ionutms/freecad-jumper-wire-pen/README.md

# Jumper wire pen

A 3D-printable pen for laying jumper wire on a circuit board, to repair broken traces. Very thin wire
(0.02 to 0.1 mm) comes off a small bought spool inside the pen, runs through the body and leaves through a
bought needle tube at the tip.

All the printed parts come from **one FreeCAD macro**. Every size is a field in a small window that stays
open next to the 3D view, and the model rebuilds a moment after you change a number.

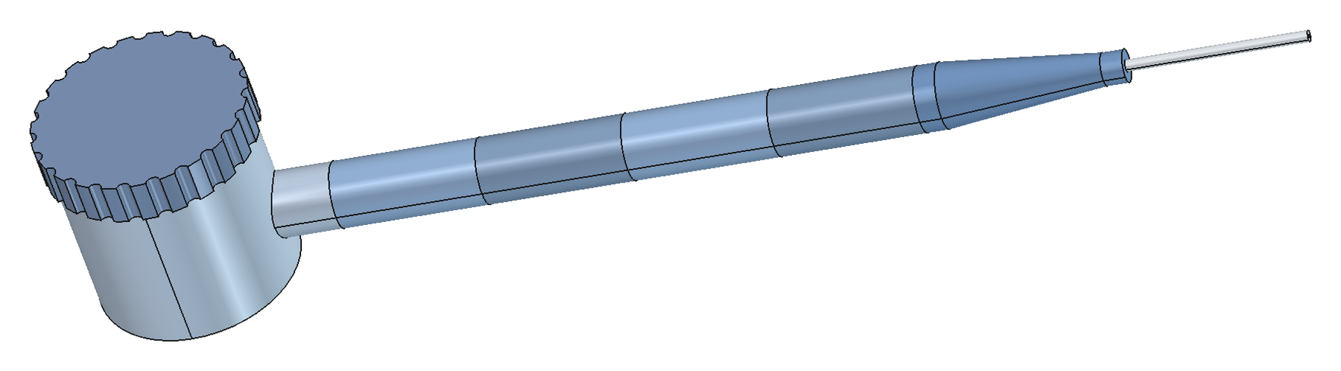
[picture p1: images/assembled.png]
The assembled pen


> **Status:** the design has not been test-printed yet. The macro checks in FreeCAD that the parts do not
> overlap (the **Check fit** button reports 0 overlap at the default sizes), but the parts have not yet been printed and
> screwed together. It was written and tried in FreeCAD 1.1 on Windows; other versions are untested.

## The parts

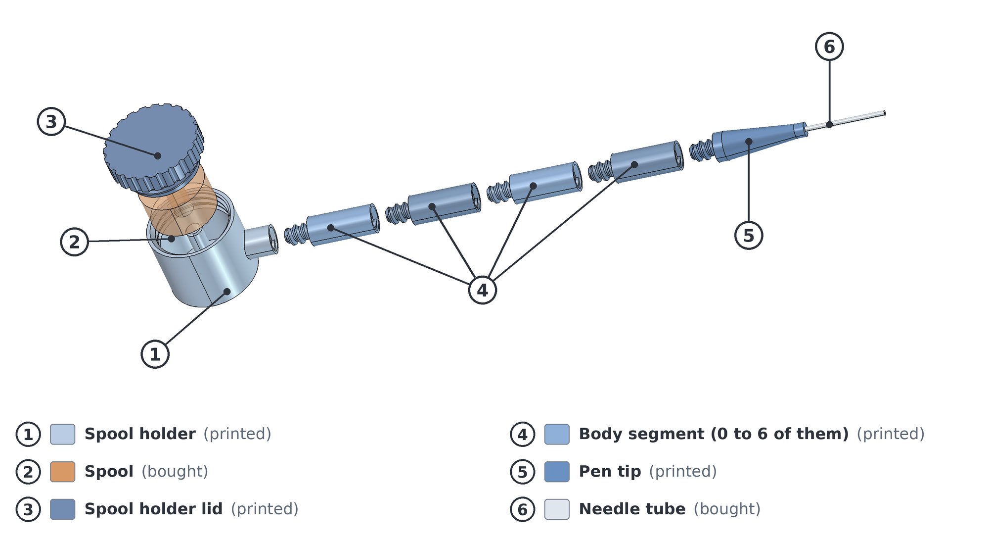
[picture p2: images/exploded_view.png]
Exploded view of the pen


| # | Part | Printed or bought | What it does |
| --- | --- | --- | --- |
| 1 | Spool holder | printed | Round drum at the rear of the pen. The spool lies on its side inside, on a pin, centred on the pen axis. One threaded socket at the front takes the first body segment (or the tip). |
| 2 | Spool | bought | Not printed. The defaults are set for a small spool: 21 mm across, 12 mm wide, centre hole 6 mm. |
| 3 | Spool holder lid | printed | The big round knob on top. It screws on and off by hand. Its hub holds the top end of the pin. Mostly hollow, to save plastic. |
| 4 | Body segment | printed | All segments are identical: a threaded stub at one end, a threaded socket at the other. Use 0 to 6 of them to set the length of the pen. |
| 5 | Pen tip | printed | The tapered nose. It holds the needle tube. |
| 6 | Needle tube | bought | Not printed. The default is 1.6 mm outside diameter, 0.6 mm inside, 25 mm sticking out of the tip. |

The wire leaves the rim of the spool into a funnel, runs along the pen through a 1.5 mm hole in every part and comes out of the needle tube.
Put together with the default sizes and 4 body segments, the pen is 143 mm long.

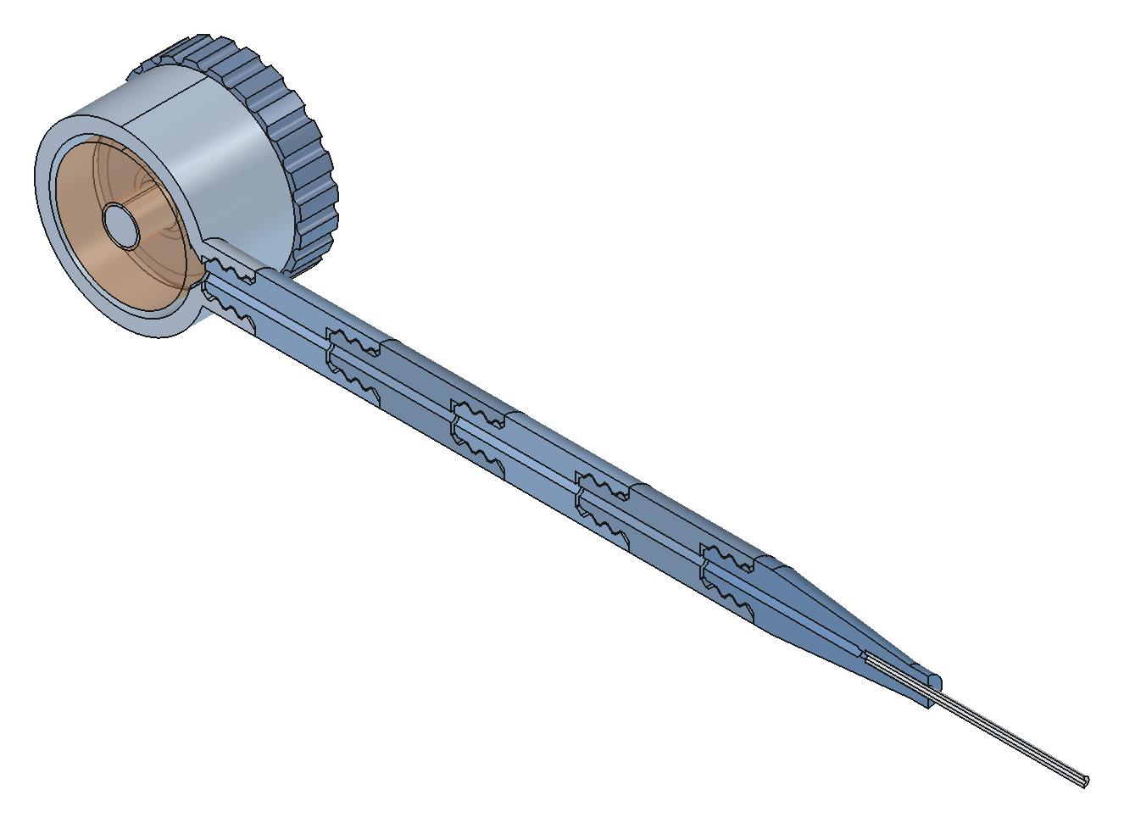
[picture p3: images/section_iso.png]
Cut through the middle of the pen


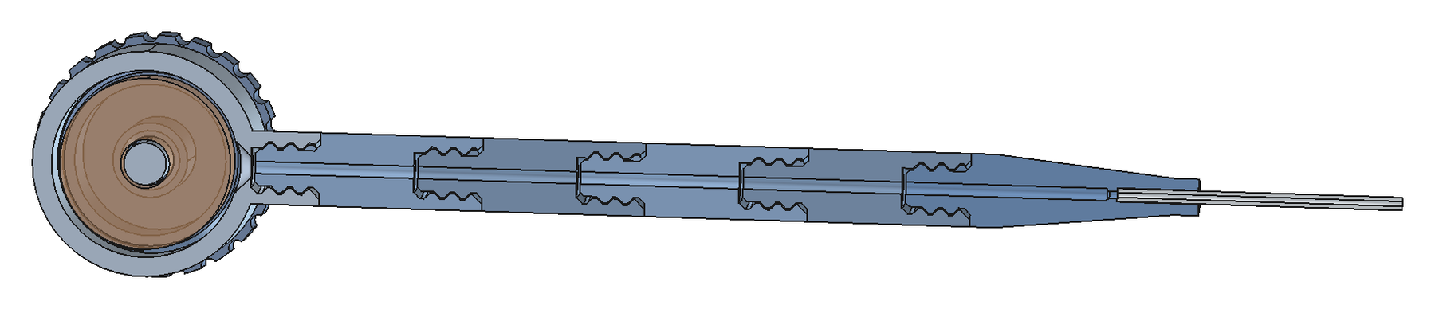
[picture p4: images/section_side.png]
Side view of the cut, showing the threads


## Install and run

1. Install [FreeCAD](https://www.freecad.org/).
2. Copy `jumper_wire_pen_assembly.FCMacro` into your FreeCAD macro folder (the folder shown in **Macro > Macros...**).
3. Choose **Macro > Macros...**, pick `jumper_wire_pen_assembly`, and press **Execute**.

A window opens and **stays open** while you work, so you can change sizes and watch the 3D view. The macro creates a
document called `JumperWirePen_Assembly` for you. Your last values are remembered. Running the macro again replaces the window.
Close the window when you are done.

## The window

Every setting has a tab. The text under the tabs shows the resulting pen length, the thread numbers, the fit,
and any warnings. If a value makes a part impossible (for example a thread too short for its step), the model keeps its last good shape and the text says why.

Buttons: **Check fit** puts the parts together as they really mate and reports the overlap of every joint (it can take up to a
minute). **Reset sizes** puts all sizes and view options back to their defaults. **Fit view** frames the model. **Close** closes the window.

### Tip shape

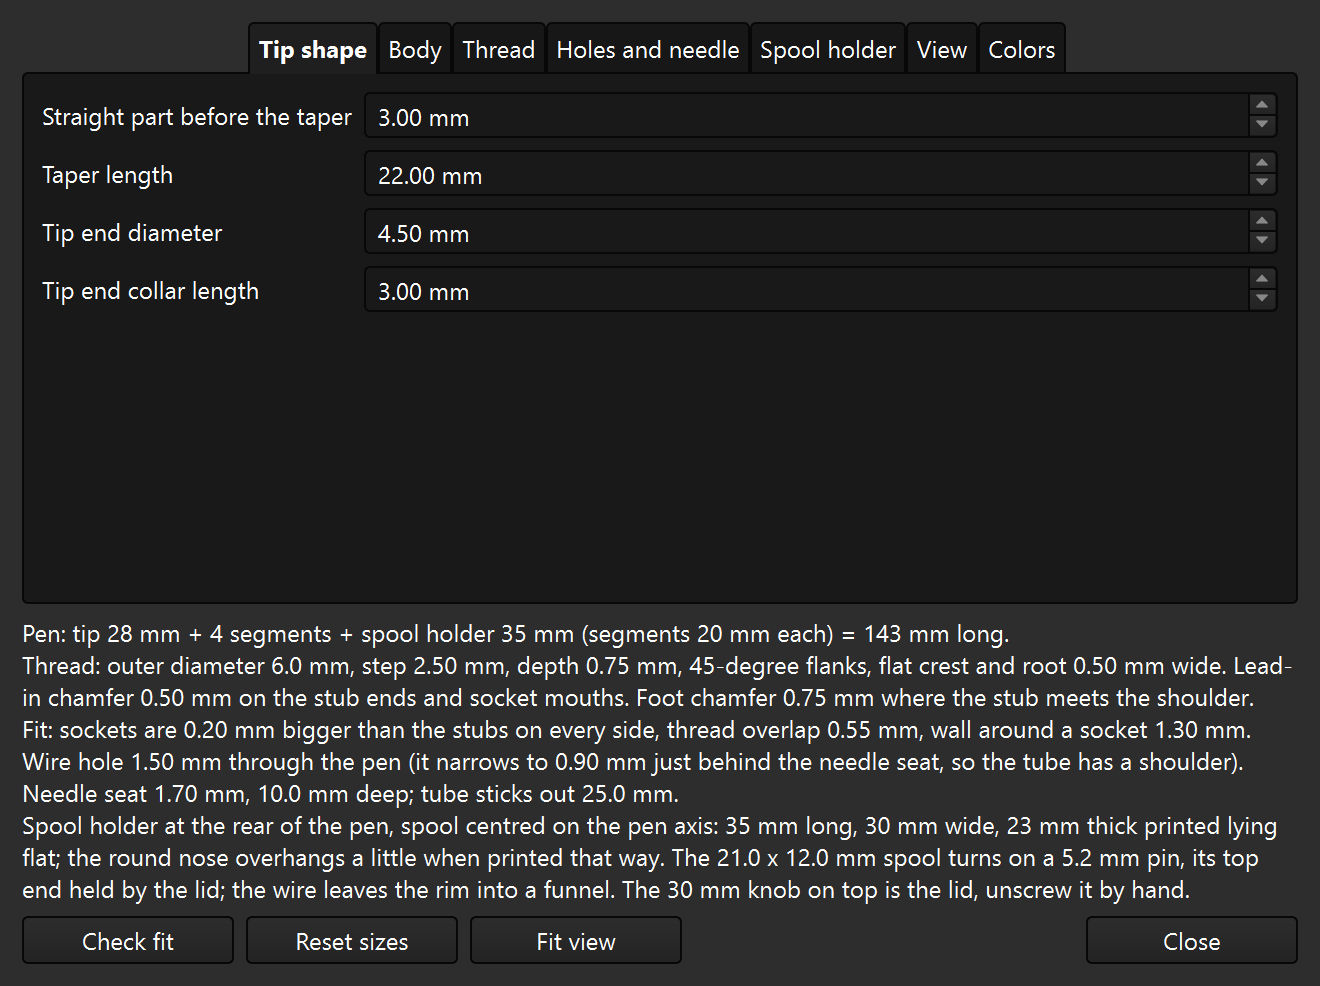
[picture p5: images/tab_1_tip_shape.png]
Tip shape tab


| Setting | Default | Range |
| --- | --- | --- |
| Straight part before the taper | 3 mm | 0.5 to 20 mm |
| Taper length | 22 mm | 5 to 100 mm |
| Tip end diameter | 4.5 mm | 3 to 15 mm |
| Tip end collar length | 3 mm | 1 to 15 mm |

### Body

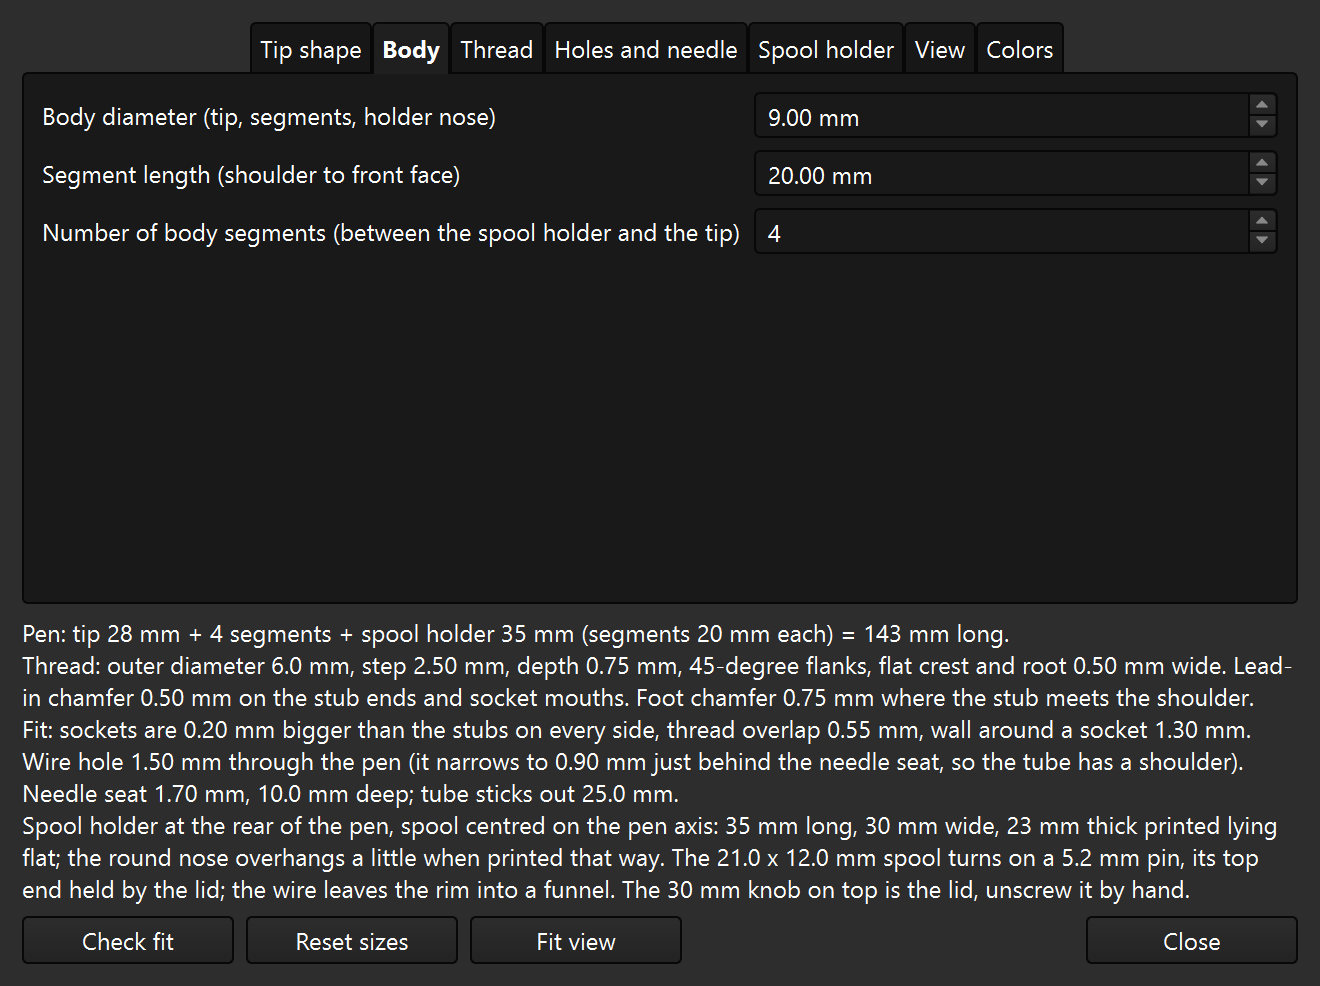
[picture p6: images/tab_2_body.png]
Body tab


| Setting | Default | Range |
| --- | --- | --- |
| Body diameter (tip, segments, holder nose) | 9 mm | 6 to 30 mm |
| Segment length (shoulder to front face) | 20 mm | 6 to 60 mm |
| Number of body segments (between the spool holder and the tip) | 4 | 0 to 6 |

The body diameter is shared by the tip, the segments and the nose of the spool holder.

### Thread

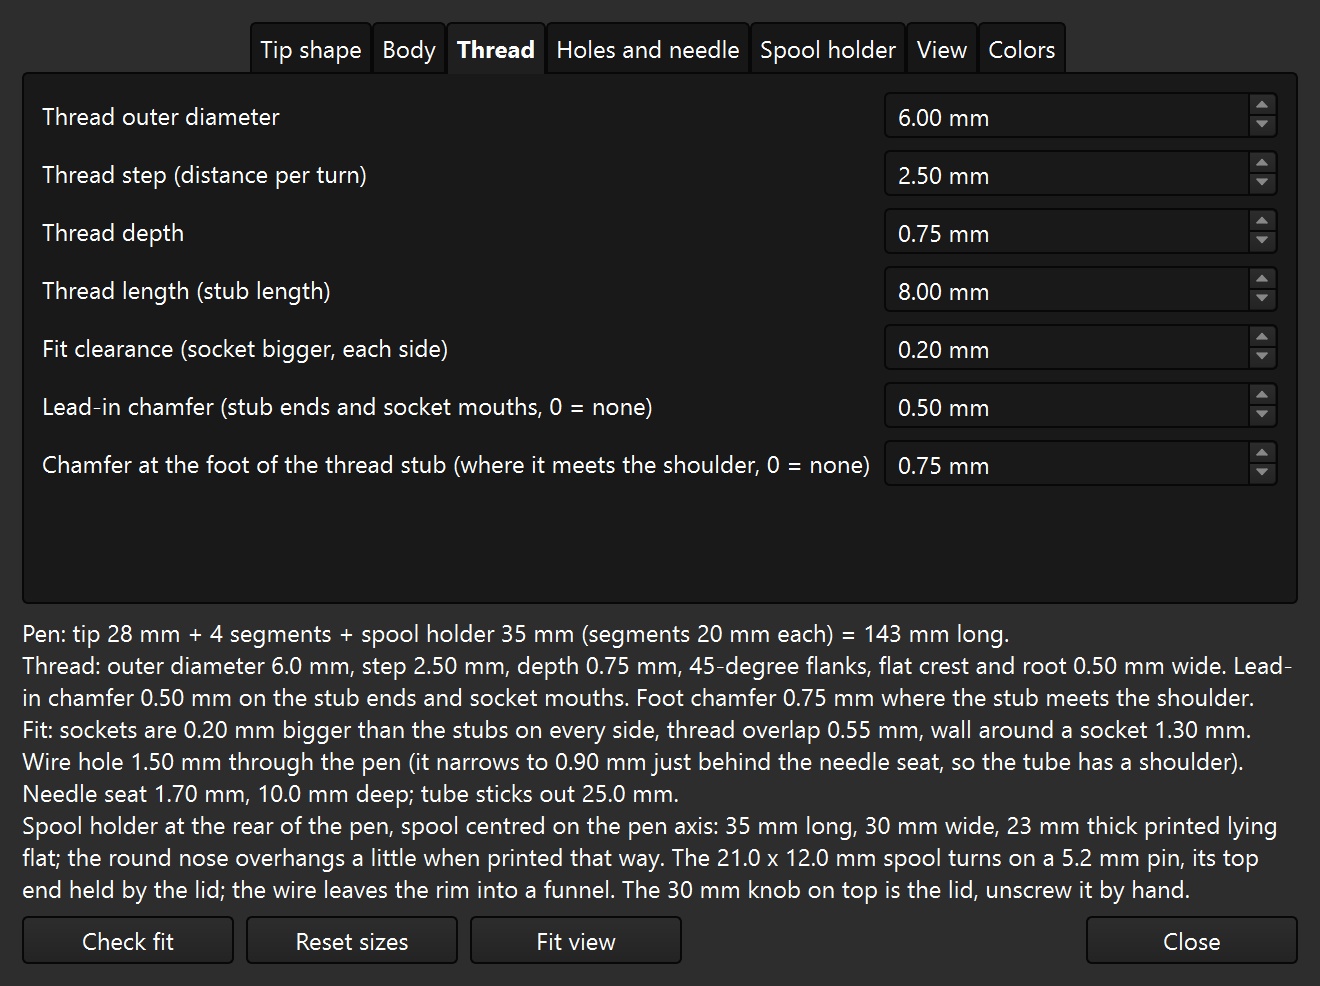
[picture p7: images/tab_3_thread.png]
Thread tab


| Setting | Default | Range |
| --- | --- | --- |
| Thread outer diameter | 6 mm | 3 to 28 mm |
| Thread step (distance per turn) | 2.5 mm | 1 to 6 mm |
| Thread depth | 0.75 mm | 0.3 to 2.5 mm |
| Thread length (stub length) | 8 mm | 4 to 24 mm |
| Fit clearance (socket bigger, each side) | 0.2 mm | 0 to 0.6 mm |
| Lead-in chamfer (stub ends and socket mouths, 0 = none) | 0.5 mm | 0 to 1.5 mm |
| Chamfer at the foot of the thread stub (where it meets the shoulder, 0 = none) | 0.75 mm | 0 to 1.5 mm |

The thread is shared by every part, so the parts always fit each other. It is made for FDM printing: a coarse step,
45-degree flanks (no flat overhangs), and flat crests and roots that are wider than one nozzle line (0.50 mm at the defaults).
The sockets are bigger than the stubs by the fit clearance on every side. If the threads bind or wobble on your printer, change that clearance.
If you change any thread setting, reprint all the parts, not just one.

Two small chamfers make the printed threads easier to use. The *lead-in chamfer* (0.5 mm) bevels the end of every
thread stub and opens every socket mouth with a matching 45-degree countersink. The parts start easily, and the squashed first layer
of a stub (it prints standing on the bed) no longer catches. The *foot chamfer* (0.75 mm) is a 45-degree slope where
the stub meets the shoulder, which makes the stub stronger. It sits inside the countersink of the socket, so the flat shoulder ring
still seats against the front face of the next part. Set either to 0 for a sharp edge. The foot chamfer is limited automatically
to the room the socket leaves for it.

### Holes and needle

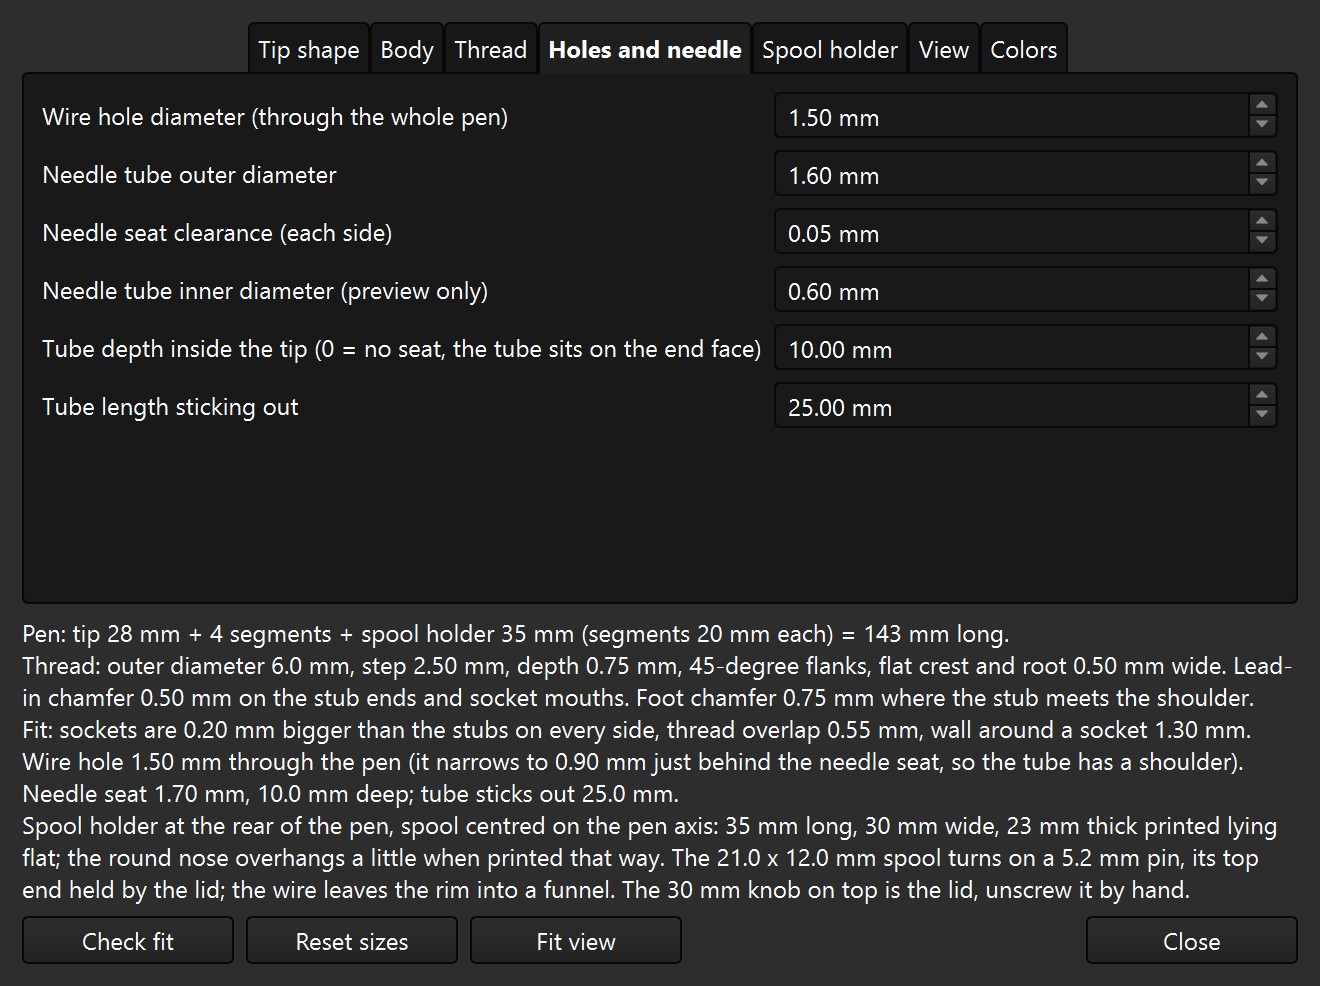
[picture p8: images/tab_4_holes_and_needle.png]
Holes and needle tab


| Setting | Default | Range |
| --- | --- | --- |
| Wire hole diameter (through the whole pen) | 1.5 mm | 0.3 to 6 mm |
| Needle tube outer diameter | 1.6 mm | 0.6 to 6 mm |
| Needle seat clearance (each side) | 0.05 mm | 0 to 0.5 mm |
| Needle tube inner diameter (preview only) | 0.6 mm | 0.2 to 5 mm |
| Tube depth inside the tip (0 = no seat, the tube sits on the end face) | 10 mm | 0 to 40 mm |
| Tube length sticking out | 25 mm | 5 to 60 mm |

Set the tube depth to 0 for a tip without a seat: the tube then sits on the end face of the tip, and you glue it there.

If the wire hole is almost as wide as the needle seat (as it is at the defaults, with a 1.5 mm hole and a
1.6 mm needle), the tube would have almost no shoulder to stop against. In that case the wire hole narrows with a
45-degree cone to a short neck just behind the seat, so the needle always has a shoulder. The text under the tabs reports the neck size.

### Spool holder

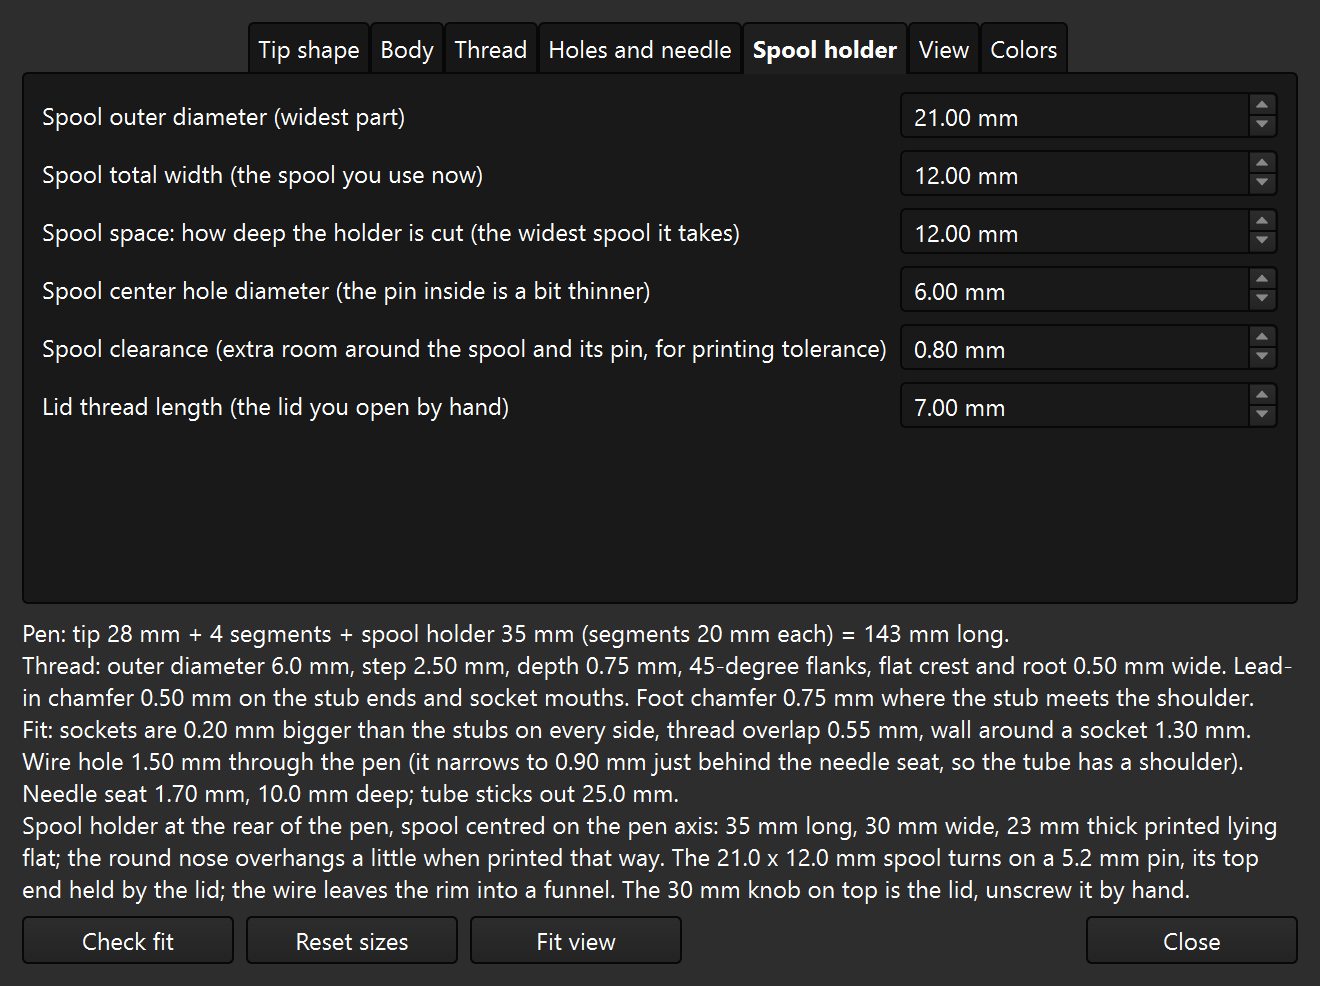
[picture p9: images/tab_5_spool_holder.png]
Spool holder tab


| Setting | Default | Range |
| --- | --- | --- |
| Spool outer diameter (widest part) | 21 mm | 8 to 60 mm |
| Spool total width (the spool you use now) | 12 mm | 2 to 30 mm |
| Spool space: how deep the holder is cut (the widest spool it takes) | 12 mm | 2 to 40 mm |
| Spool center hole diameter (the pin inside is a bit thinner) | 6 mm | 1 to 15 mm |
| Spool clearance (extra room around the spool and its pin, for printing tolerance) | 0.8 mm | 0 to 2 mm |
| Lid thread length (the lid you open by hand) | 7 mm | 3 to 16 mm |

*Spool space* sets how deep the holder is cut, so it decides the widest spool the holder takes. *Spool total width* is the spool you
use now. If your spool is narrower than the space, the text under the tabs tells you how many millimetres of washers or spacers to put
under it to keep it centred on the pen axis.

*Spool clearance* (0.8 mm by default) is extra room for printing tolerance, so that the spool still fits a printed holder. It leaves
1 mm of free space around the rim of the spool, 0.6 mm of play above and below it, and makes the pin 0.8 mm thinner
than the centre hole of the spool. Raise it if your spool is tight, lower it if the spool wobbles too much.

The defaults are set for a small spool (21 mm across, 12 mm wide, centre hole 6 mm). At these sizes the spool holder is the biggest part of the pen: 35 mm long, 28 mm wide and 23 mm thick, and 30 mm across the lid knob.

The lid has one setting of its own, the lid thread length. The lid thread is sized from the spool diameter, and its step, depth and
clearance are the shared thread settings. The holder length depends on the thread length of the body, because the first body segment
screws into the holder.

### View

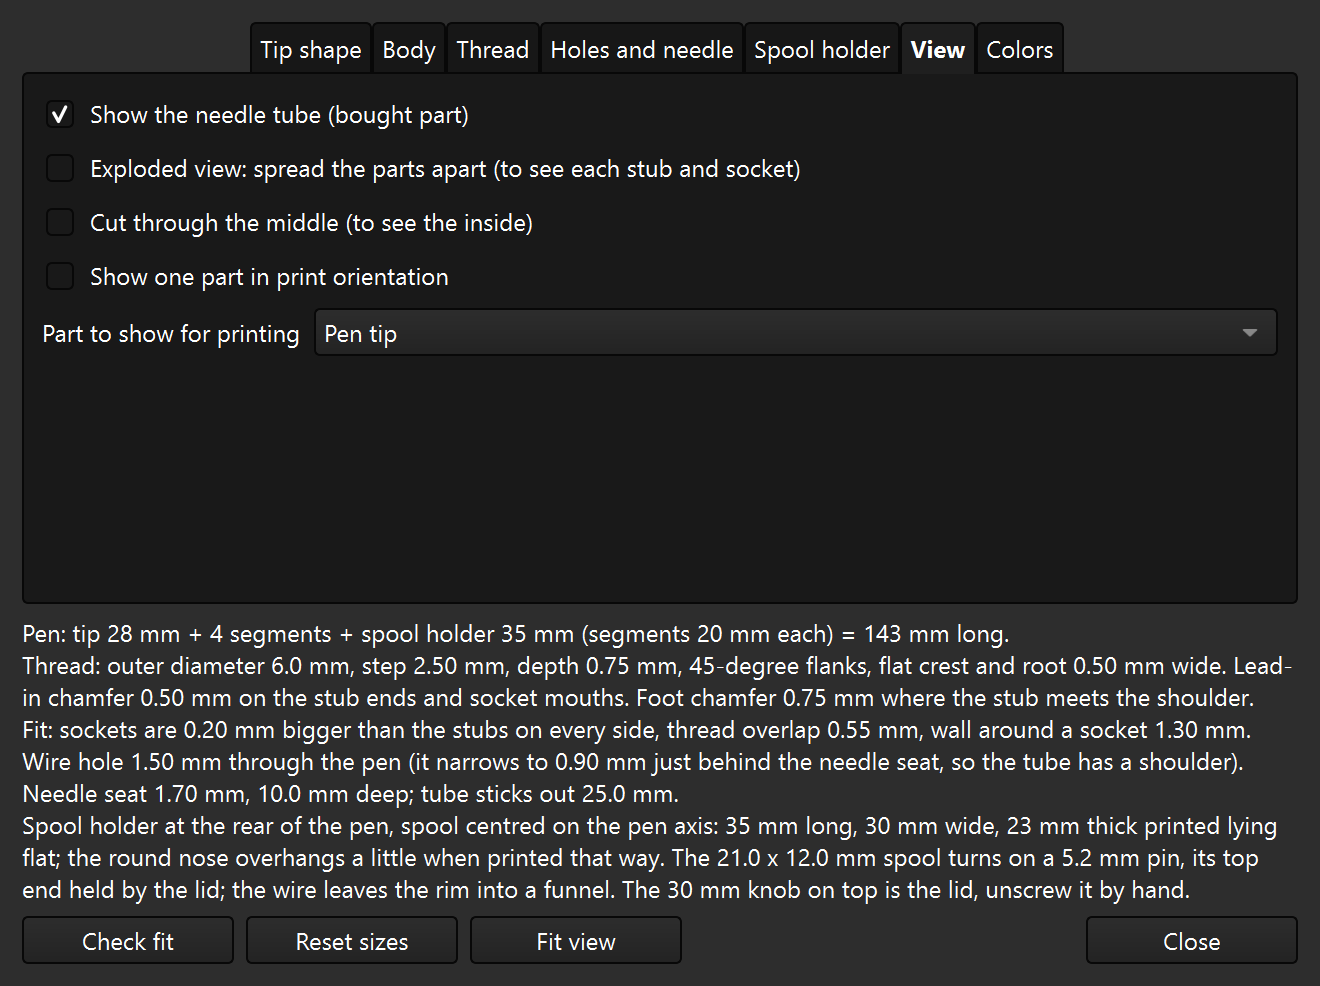
[picture p10: images/tab_6_view.png]
View tab


* **Show the needle tube**: shows or hides the bought needle tube.
* **Exploded view**: spreads the parts apart so you can see every stub and socket. The spool and the lid lift clear of the holder. The exploded picture near the top is this view with numbers added.
* **Cut through the middle**: cuts the model in half to show the inside.
* **Show one part in print orientation**: shows only the part chosen in *Part to show for printing*, turned the way it is printed.

### Colors

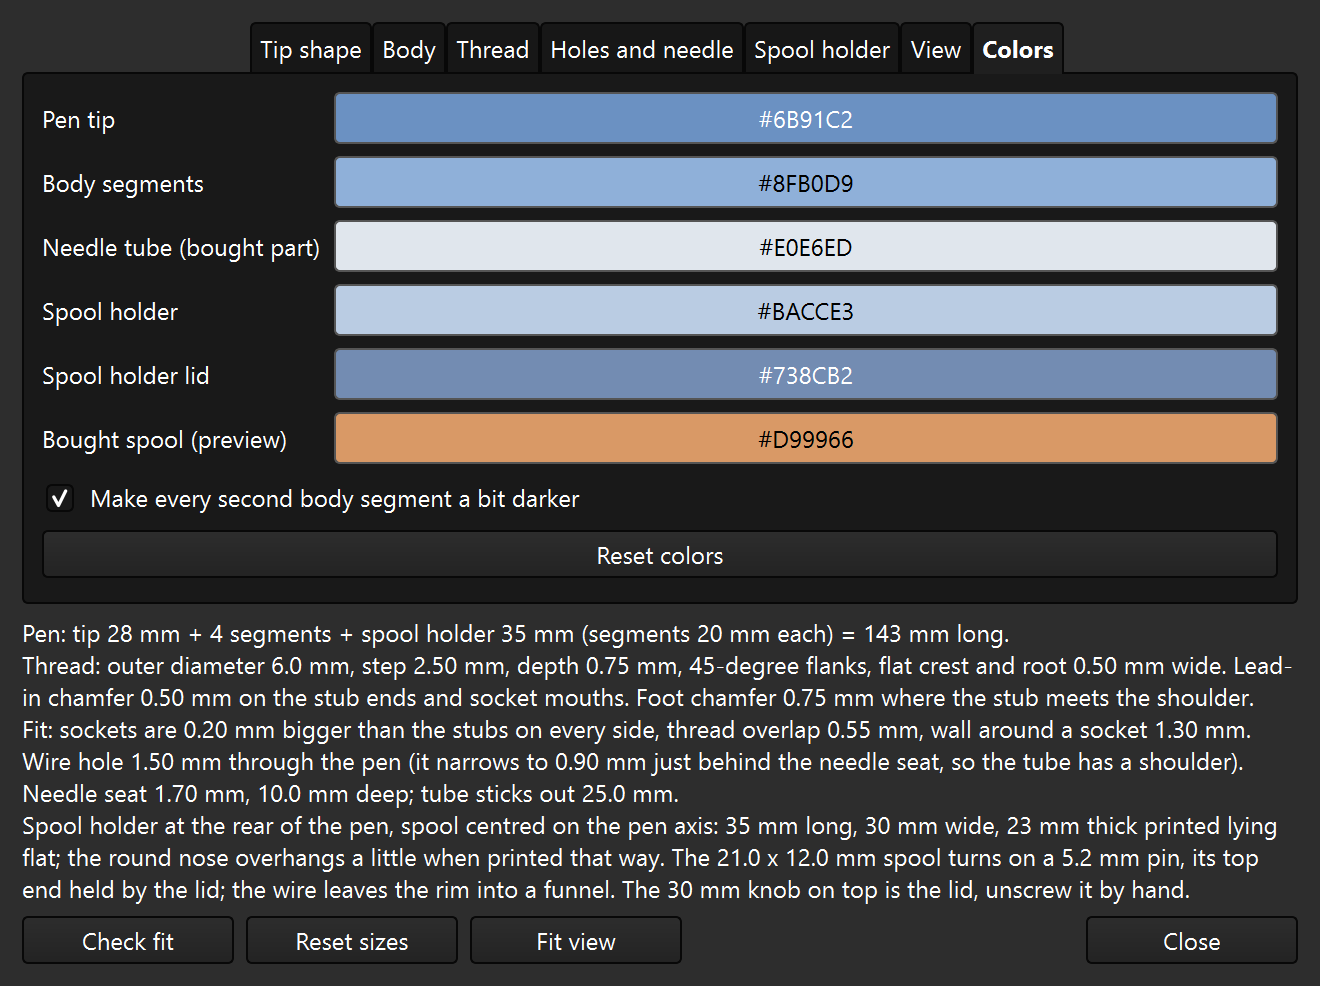
[picture p11: images/tab_7_colors.png]
Colors tab


Click a color to change the display color of a part. Optionally every second body segment is drawn a bit darker. **Reset colors** restores the defaults.

## Printing

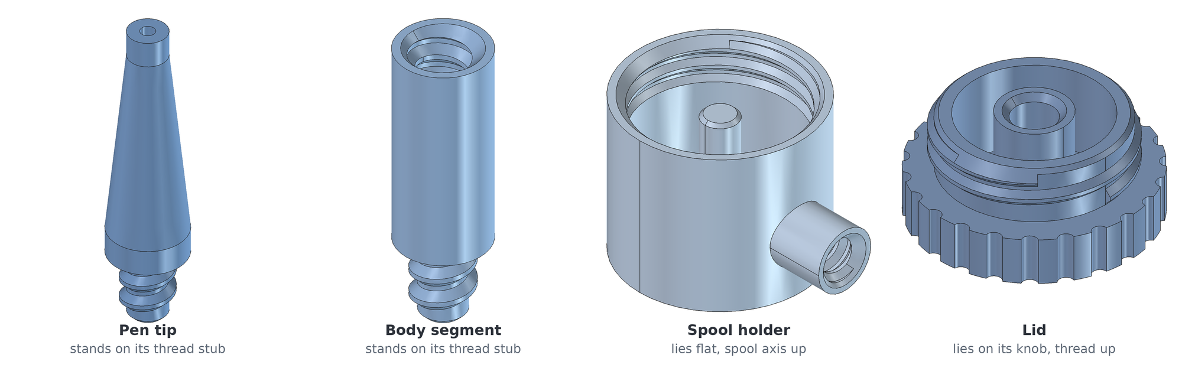
[picture p12: images/print_orientation.png]
The four printed parts in print orientation


The pictures are not to scale. The pen tip and the body segments stand on their thread stub. The spool holder lies flat with the spool axis pointing up.
The lid lies on its knob with the thread pointing up. Because the holder lies flat, its round nose overhangs a little when printed that way.

To get a file for the slicer at other sizes:

1. In the **View** tab, tick **Show one part in print orientation** and pick the part.
2. Select that part in the FreeCAD model tree.
3. Choose **File > Export...** and save it as an STL file.

Print one tip, one holder, one lid and as many segments as you set in the **Body** tab (4 at the defaults).

## STEP files

The `models/` folder has a STEP file for each printed part, made at the default sizes and turned the way the part is printed (see the picture in the Printing section).

| File | Part | How many to print | Size when printed (mm) |
| --- | --- | --- | --- |
| `models/pen_tip.step` | Pen tip | 1 | 9 x 9 x 36 |
| `models/body_segment.step` | Body segment | 4 | 9 x 9 x 28 |
| `models/spool_holder.step` | Spool holder | 1 | 35.4 x 27.7 x 22.7 |
| `models/spool_holder_lid.step` | Spool holder lid | 1 | 29.7 x 29.7 x 13.3 |

Many slicers (PrusaSlicer, for example) open STEP files directly; for other slicers, convert the file to STL. These files only fit the default sizes. For other sizes, run the macro and export the parts as described above.

## Shopping list

* Needle tube (default 1.6 mm outside diameter, 0.6 mm inside; change the sizes in the **Holes and needle** tab if yours differ).
* A spool of very thin enamelled wire (0.02 to 0.1 mm). The defaults are set for a small spool: 21 mm across, 12 mm wide, centre hole 6 mm. Measure your own spool with calipers and set its sizes in the **Spool holder** tab if it differs.
* Optional: washers or spacers for a spool that is narrower than the spool space.

## Known limits

* Not test-printed yet (see the status note at the top).
* The holder length follows the body thread length, because the first segment screws into the holder.
* A spool narrower than the spool space needs washers or spacers to stay centred.
* The round nose of the holder overhangs a little when the holder is printed flat.

## Files

| File | What it is |
| --- | --- |
| `jumper_wire_pen_assembly.FCMacro` | The macro. It is the only file you need to build the pen. |
| `models/` | STEP files of the four printed parts at the default sizes. |
| `images/` | The pictures used in this README. |
| `LICENSE` | The MIT license. |

## License

MIT License. See [LICENSE](LICENSE).
