ionutms/freecad-jumper-wire-pen/models/pen_tip.step

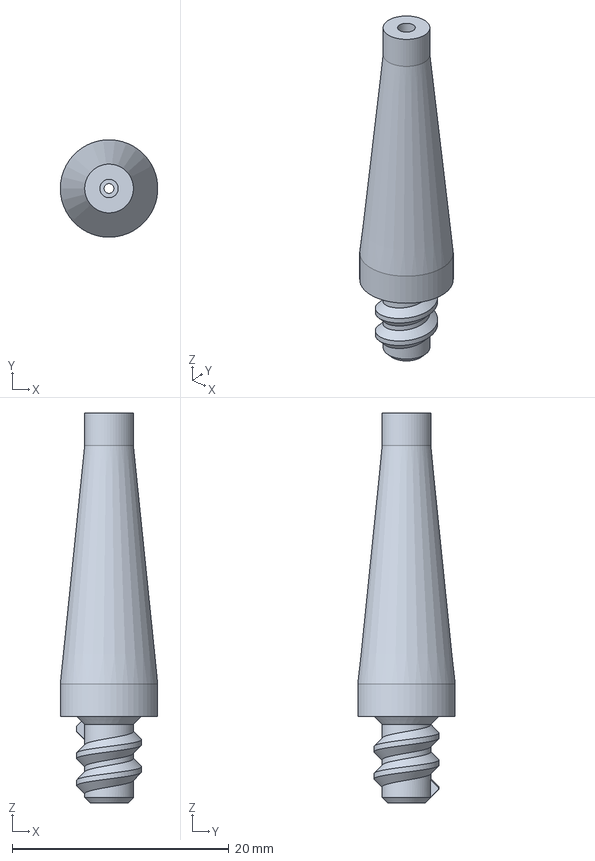
[picture p13: CAD file, 2026-11-05]
models/pen_tip.step
8.99 x 9.00 x 36.0 mm
