ionutms/freecad-jumper-wire-pen/models/spool_holder.step

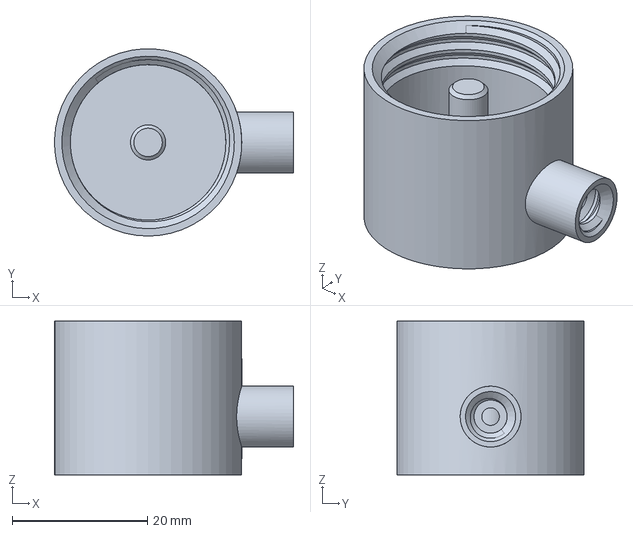
[picture p14: CAD file, 2026-11-05]
models/spool_holder.step
35.3 x 27.7 x 22.7 mm
