ionutms/freecad-jumper-wire-pen/models/body_segment.step

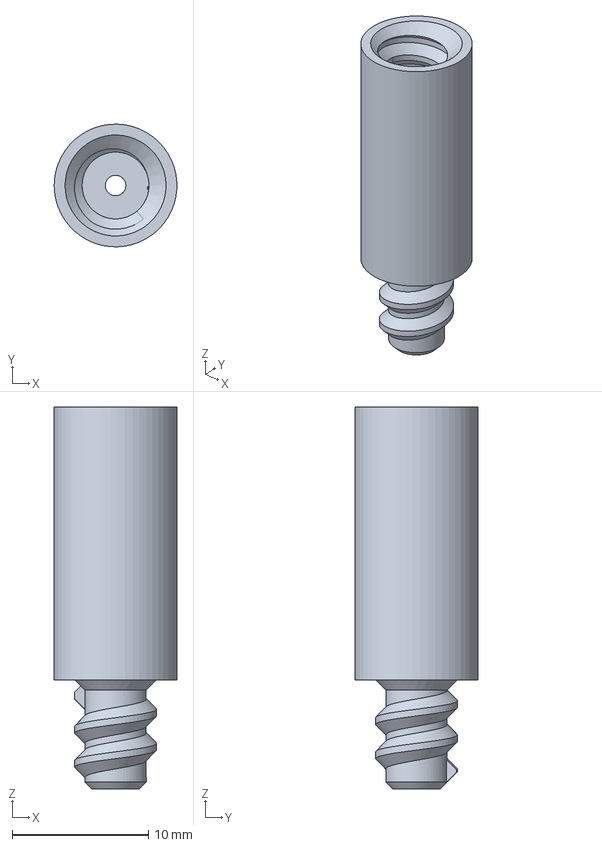
[picture p15: CAD file, 2026-11-05]
models/body_segment.step
8.99 x 9.00 x 28.0 mm
