ionutms/freecad-jumper-wire-pen/models/spool_holder_lid.step

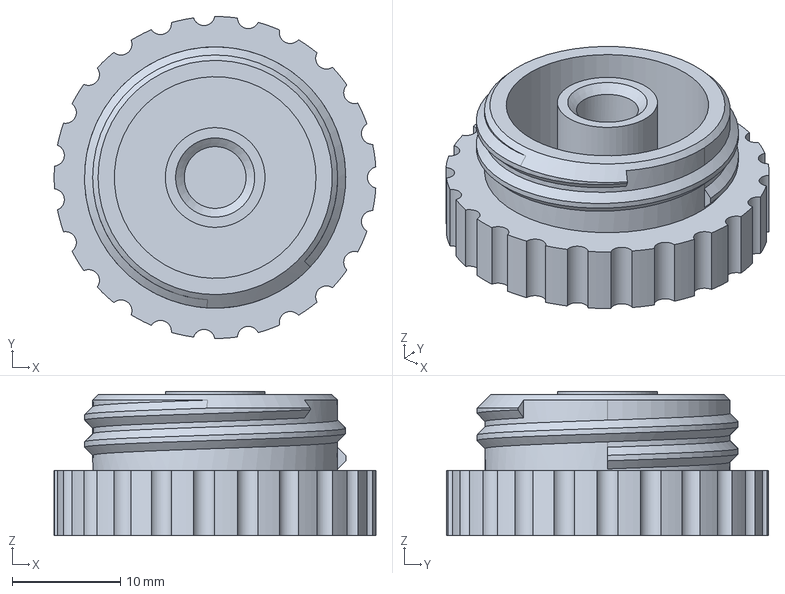
[picture p16: CAD file, 2026-11-05]
models/spool_holder_lid.step
29.7 x 29.7 x 13.3 mm
