ionutms/freecad-jumper-wire-pen/(commit log)

2026-11-01 Add FreeCAD jumper wire pen macro, images, and README docs
2026-11-04 Default to LD10-MIX spool and 4 segments, add STEP models and exploded view
    - Spool defaults are now 30 x 13 mm with an 8 mm centre hole (Donau LD10-MIX).
    - Default number of body segments is 4.
    - Exploded view lifts the spool and the lid clear of the holder.
    - Add STEP files of the four printed parts in models/.
    - Refresh the README and all screenshots.
    [body_segment.step, pen_tip.step, spool_holder.step, spool_holder_lid.step]
2026-11-05 Smaller spool holder, spool clearance, wire-hole neck and thread chamfers
    - Default spool is now 21 mm across, 12 mm wide with a 6 mm centre hole; the holder is 35 x 28 x 23 mm
    - New Spool clearance setting (0.8 mm) adds room around the spool and its pin for printing tolerance
    - Wire hole default is 1.5 mm; it narrows to a neck behind the needle seat so the needle keeps a shoulder
    - New lead-in chamfer (stub ends and socket mouths) and foot chamfer (stub root) settings
    - Keep the cut-through view working: only keep a face-merged shape if it still survives the half cut
    - Regenerate the README, screenshots and STEP files at the new defaults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
    [body_segment.step, pen_tip.step, spool_holder.step, spool_holder_lid.step]
